crhan/frenchfinity-openscad/src/screw_driver.scad

module screw_driver_positive () {
    module stick () {
        cylinder(
            d=screwdriver_stick_width, 
            h=screwdriver_bottom_height, 
            center=false, 
            $fn=100
        );
    }
    
    module handle () {
         cylinder(
            d=screwdriver_handle_width,
            h=screwdriver_inset_height,
            center=false,
            $fn=100
        );
        
        rotate_extrude(convexity = 10)
            translate([screwdriver_handle_width / 2, screwdriver_inset_height, 0])
                circle(r = 1.5, $fn = 100);
    }
    
    union () {
        up(screwdriver_inset_height)
            handle();
        stick();
    }
}   

module screw_driver_clearance(base_height) {
    half_handle_width = screwdriver_handle_width / 2;
    half_stick_width  = screwdriver_stick_width / 2;
    polygon_front_end = half_handle_width + screwdriver_padding_sides;

    union () {
        linear_extrude(height = base_height, center= false)
        polygon([
           [-half_stick_width,  0],
           [half_stick_width,   0],
           [half_handle_width , polygon_front_end],
           [-half_handle_width, polygon_front_end]
        ]);
        rounded_corner(
            [-half_stick_width,  0, base_height],
            [-half_handle_width, polygon_front_end, base_height], 
            1.5
        );
        rounded_corner(
            [half_stick_width,  0, base_height],
            [half_handle_width, polygon_front_end, base_height], 
            1.5
        );
    }
}

module screw_driver_base (base_height, base_width_and_depth) {
    module raw_base () {        
        up(screwdriver_bottom_height)
            cube(
                [
                    base_width_and_depth,
                    base_width_and_depth,
                    base_height
                ], 
                center=true
            ); 
    }


    difference () {
        raw_base(); 
        screw_driver_clearance(base_height);
        screw_driver_positive();
    }
}

module screw_driver_holder_without_nut (base_height, base_width_and_depth) {
    module back_plate () {
        up(base_height)
        back(-base_width_and_depth/2)
        yrot(270)
        linear_extrude(height = base_width_and_depth, center= true)
        polygon(
            [
                [0,  0],
                [0,  screwdriver_padding_sides - 2],
                [screwdriver_padding_top,  screwdriver_padding_sides / 2],
                [screwdriver_padding_top ,  0],
            ],
            [[0, 1, 2, 3]]
        );
    }
    
    union () {
        back_plate();
        screw_driver_base(base_height, base_width_and_depth);
    }
}

module screw_driver_holder_without_nut_and_text (base_height, base_width_and_depth) {
    labels = hintFileName([
        final_version_prefix_calculated,
        [
            str("bh", screwdriver_bottom_height),
            str("hw", screwdriver_handle_width)
        ],
        [
            str("ps", screwdriver_padding_sides),
            str("pt", screwdriver_padding_top)
        ],
        [
            str("sw", screwdriver_stick_width),
            str("ih", screwdriver_inset_height)
        ],
    ]);

    difference() {
        screw_driver_holder_without_nut(base_height, base_width_and_depth);
        // Front face of the back plate, between the base and the cleat, never
        // smaller than the 1.0 glyph.
        labelLines(labels,
            ["x", 0, -base_width_and_depth / 2, base_width_and_depth,
             base_height + 2, base_height + screwdriver_padding_top - 14]);
    }
}

module feature_screw_driver () {
    base_height          = screwdriver_bottom_height + screwdriver_inset_height;
    base_width_and_depth = screwdriver_handle_width + (screwdriver_padding_sides * 2);
    
    up(base_height + screwdriver_padding_top - (frenchfinity_1_0_slot_distance_top * 2))
    left(base_width_and_depth/2)
    back(-base_width_and_depth/2)
    mirror([0, 1, 0])
    nut(base_width_and_depth, false);
    
    screw_driver_holder_without_nut_and_text(base_height, base_width_and_depth);
}
