crhan/frenchfinity-openscad/src/can_holder.scad

//
// Can holder  (a.k.a. can / drill / spray-can holder)
//
// Reverse engineered from the Frenchfinity 1.0 "Can-Holder" by measuring the
// reference STLs (NOT by fitting the bounding box). Fusion user parameters and
// what they ACTUALLY drive:
//
//   can_diameter (cd)  -> the can/tube the bore must fit; bore = cd + clearance
//   padding      (p)   -> SIDE/front wall around the bore; sets width dx = cd+2*p
//   can_inset    (ci)  -> bore DEPTH measured along the (tilted) bore axis
//   padding_left (pl)  -> BACK / base material
//   angle        (a)   -> how far the bore (and the can) lean OUT from vertical.
//                         This is a free 1.0 user knob (NOT encoded in the file
//                         names; the reference STLs use 10/15/20/30/40 deg). The
//                         earlier port hard-coded ~9 deg, which is why most
//                         samples looked wrong.
//
// Shape (verified against the reference STLs, every angle/perpendicularity is
// exact by construction so it tracks any `angle`):
//   * a tall UPRIGHT block, width cd+2*p, sitting on a flat base;
//   * a blind bore drilled along an axis tilted `angle` from vertical, so the can
//     leans outward (top away from the wall, easy to grab);
//   * the FRONT face is PARALLEL to the bore axis (leans out `angle` from
//     vertical), the side walls stay a constant ~p;
//   * the TOP is PERPENDICULAR to the bore axis -> a flat back deck plus a sloped
//     "roof" running down to the front-top edge (this is the sloped top the 1.0
//     has and the old flat-top port was missing);
//   * the bore mouth has a 45 deg lead-in chamfer (countersink) so the can drops
//     in easily;
//   * the vertical edges carry a small fillet (the 1.0 rounds them ~1 mm).
//   * the back wall is vertical and carries the french cleat at the top; the
//     "-hole-bottom" 1.0 variant adds a drain/push-out hole (can_holder_bottom
//     = "open").
//
// Derived size relations (consequences of the geometry; track the 1.0 STLs):
//   dx = cd + 2*p                                   (exact)
//   front face & bore lean `angle` from vertical    (exact by construction)
//   top plane is perpendicular to the bore axis      (exact by construction)
//
// Orientation: back wall (cleat) at +Y, can leans toward -Y... actually the bore
// leans toward +Y (front) going up; the cleat sits on the vertical back face.
//

can_holder_clearance = 2;     // bore = can_diameter + this (fit slack; measured cd+2)
can_holder_leadin    = 3;     // 45 deg lead-in chamfer at the bore mouth
can_holder_fillet    = 2;     // rounding radius on the FRONT + TOP edges (1.0 rounds
                              // these); the BACK / cleat edges stay sharp (joint fit)
can_holder_drain     = 6;     // drain hole diameter for bottom = "open"
can_holder_bore_bottom_extra = 4;
can_holder_text_epsilon = 0.02;
can_holder_end_roundover_excess = 0.05;

function can_holder_label_value (v) = format_fixed(v, 2);

function can_holder_outer_width () =
    can_holder_can_diameter + 2 * can_holder_padding;

function can_holder_bore_d () =
    can_holder_can_diameter + can_holder_clearance;

// --- Empirical dimension laws, fitted to ALL 50+ 1.0 Can-Holder STLs ----------
// The 1.0 part is a free-parameter family in (cd, pl, ci, p, angle); the angle is
// NOT in the file names but is one of 10/15/20/30/40 deg. Measuring every sample
// gives these laws (max residual < 0.5 mm across the whole set). They are imitation
// fits, not first-principles - the 1.0 top geometry over-constrains a clean model,
// so we reproduce the measured bounding box + deck directly.
//   dx   = cd + 2p                                   (exact)
//   deck = pl                                         (flat top depth)
//   bore = cd + 2                                     (clearance 2)
//   dy   = 10.9(cleat) + pl + C ;  dz = ci*cos(a) + K
function can_holder_C () =
    let (cd = can_holder_can_diameter, p = can_holder_padding,
         t  = tan(can_holder_angle))
    1.0122 * cd + 1.8276 * p
    - 0.1120 * cd * t - 0.2464 * cd * t * t
    - 9.0947 * t + 6.3539;

function can_holder_K () =
    let (cd = can_holder_can_diameter, p = can_holder_padding,
         r  = can_holder_bore_d() / 2, a = can_holder_angle)
    2.2371 * r * sin(a) + 18.3335 * sin(a)
    - 0.1059 * cd * tan(a) + 1.5820 * p - 5.3775;

// solid base height below the lowest bore point (measured: ~9 + 0.3*pl)
function can_holder_base () = 9 + 0.3 * can_holder_padding_left;

// total part height dz = ci*cos(a) + K(cd,p,a)  (matches the 1.0 STL height)
function can_holder_height () =
    can_holder_can_inset * cos(can_holder_angle) + can_holder_K();

// The front+top sphere-minkowski rounding pulls the rendered max-Y point IN from
// the sharp front-top corner by this much (measured: grows smoothly with the angle,
// independent of cd/p, scales with the fillet). We build the sharp corner this much
// FURTHER out so the rounded result lands exactly on the 1.0 front (pl + C).
function can_holder_front_pullin () =
    let (a = can_holder_angle)
    (can_holder_fillet / 2) * (0.04 * a - 0.00047 * a * a);

// effective sharp front extent = the 1.0 front (pl + C) plus the rounding pull-in.
function can_holder_front_eff () = can_holder_C() + can_holder_front_pullin();

// furthest-forward point of the front face, measured from the back face (Y=0):
// the rendered (rounded) value lands on pl + C (= the 1.0 front face).
function can_holder_front_max () =
    can_holder_padding_left + can_holder_front_eff();

// Z of the front-top corner: the roof (tilt a) drops front_eff*tan(a) from the deck
// (z=H, Y=pl) to the front-top corner.
function can_holder_fronttop_z () =
    can_holder_height() - can_holder_front_eff() * tan(can_holder_angle);

// front face Y at height z (the face is parallel to the bore axis, tilts `a`).
function can_holder_front_y (z) =
    can_holder_front_max()
    - (can_holder_fronttop_z() - z) * tan(can_holder_angle);

// bore floor centre Z: base solid + r*sin(a) so the lowest bore point sits at `base`.
function can_holder_floor_z () =
    can_holder_base() + can_holder_bore_d() / 2 * sin(can_holder_angle);

// bore floor centre Y: a perpendicular front-wall thickness `p` in front of the bore,
// i.e. (r + p) perpendicular behind the front plane, at the floor height. Measured
// against the 1.0 STLs the bore sits ~0.37 mm further back than (r+p) alone gives
// (consistent across samples), so nudge it back to land on the 1.0 bore axis.
function can_holder_bore_yc () =
    can_holder_front_y(can_holder_floor_z())
    - (can_holder_bore_d() / 2 + can_holder_padding) / cos(can_holder_angle)
    - 0.37;

// generous Y depth for the footprint trimming prism (front plane cuts within it).
function can_holder_depth () = can_holder_front_max() + can_holder_padding + 10;

// Z placement origin of the cleat (nut). The nut centres slot_outer_height/2
// above its origin; the 1.0 part puts the cleat CENTRE a measured ~10.19 mm below
// the part top (constant across ci / all samples), so anchor the origin there.
function can_holder_cleat_origin () =
    can_holder_height() - 10.19 - frenchfinity_1_0_slot_outer_height / 2;

// bottom Z of the label band on the back face: kept below the cleat (unchanged so
// the engraved text is unaffected by the cleat-position fix).
function can_holder_cleat_bottom () =
    can_holder_height() - 2 * frenchfinity_1_0_slot_distance_top;

function can_holder_side_profile () =
    let (H = can_holder_height(), pl = can_holder_padding_left)
    [
        [0,                        0],
        [can_holder_front_y(0),    0],
        [can_holder_front_max(),   can_holder_fronttop_z()],
        [pl,                       H],
        [0,                        H]
    ];

function can_holder_roundover_mask2d (r, steps = 16) =
    concat(
        [[0, 0]],
        [for (i = [0 : steps])
            let (a = -90 - 90 * i / steps)
            [r + r * cos(a), r + r * sin(a)]]
    );

function can_holder_profile_outward_normal (p0, p1) =
    let (dy = p1[0] - p0[0], dz = p1[1] - p0[1], l = norm([dy, dz]))
    [0, dz / l, -dy / l];

module can_holder_edge_roundover_mask (p0, p1, outward_cap, outward_side, r) {
    eps = can_holder_end_roundover_excess;
    edge = p1 - p0;
    e    = unit(edge);
    u    = -outward_cap;   // inward from the X end cap
    v    = -outward_side;  // inward from the adjacent side/top/front face
    mid  = (p0 + p1) / 2;

    multmatrix([
        [u[0], v[0], e[0], mid[0]],
        [u[1], v[1], e[1], mid[1]],
        [u[2], v[2], e[2], mid[2]],
        [0,    0,    0,    1]
    ])
        linear_extrude(height = norm(edge) + 2 * eps, center = true, convexity = 4)
            polygon(can_holder_roundover_mask2d(r));
}

module can_holder_end_roundover_masks () {
    w = can_holder_outer_width();
    r = can_holder_fillet;
    p = can_holder_side_profile();

    // End-cap perimeter is selective: the 1.0 side view rounds the front/left
    // edge and the top edges, while the back/right and bottom edges stay sharp.
    // Profile edges: 0=bottom, 1=front, 2=sloped roof, 3=back deck, 4=back.
    for (x = [0, w])
        for (i = [1, 2, 3])
            let (
                p0 = p[i],
                p1 = p[(i + 1) % len(p)],
                cap_n = x < w / 2 ? [-1, 0, 0] : [1, 0, 0],
                side_n = can_holder_profile_outward_normal(p0, p1)
            )
                can_holder_edge_roundover_mask(
                    [x, p0[0], p0[1]],
                    [x, p1[0], p1[1]],
                    cap_n,
                    side_n,
                    r
                );
}

// The outer body is a side profile extruded along X.  Use BOSL2 rounded_prism()
// so edge roundovers are native VNF geometry, not CSG patchwork.  The joint_sides
// entries correspond to the profile vertices above: back-bottom, front-bottom,
// front-top, deck/front-roof transition, back-top.  Only the front/top vertices
// are rounded; the cleat-side back edges stay sharp for wall fit.
module can_holder_outer_shell () {
    w = can_holder_outer_width();
    f = can_holder_fillet;

    translate([w / 2, 0, 0])
        multmatrix([
            [0, 0, 1, 0],   // BOSL2 extrusion Z -> model X
            [1, 0, 0, 0],   // BOSL2 profile X   -> model Y
            [0, 1, 0, 0],   // BOSL2 profile Y   -> model Z
            [0, 0, 0, 1]
        ])
            rounded_prism(
                bottom       = can_holder_side_profile(),
                height       = w,
                joint_sides  = [0, 0, f, f, 0],
                joint_bot    = 0,
                joint_top    = 0,
                k_sides      = 0.92,
                splinesteps  = 16
            );
}

module can_holder_body () {
    w     = can_holder_outer_width();
    a     = can_holder_angle;
    r     = can_holder_bore_d() / 2;
    base  = can_holder_base();
    fil   = can_holder_fillet;
    cs    = can_holder_leadin;
    yc0   = can_holder_bore_yc();
    zf    = can_holder_floor_z();
    Cf    = [w / 2, yc0, zf];                  // bore floor centre
    H     = can_holder_height();
    // axial floor -> roof opening = perpendicular distance from Cf to the roof plane
    // (roof through (pl,H), normal = bore axis), so the bore exits flush at the roof.
    L     = sin(a) * (can_holder_padding_left - yc0) + cos(a) * (H - zf);

    // One BOSL2 VNF shell with selective edge roundovers: rounded front/top
    // edges, sharp back/cleat edges, and no union seam between those treatments.
    difference () {
        can_holder_outer_shell();
        can_holder_end_roundover_masks();

        // bore drilled along the tilted axis (leans +Y going up), 45 deg lead-in.
        translate(Cf)
            rotate([-a, 0, 0]) {
                translate([0, 0, -can_holder_bore_bottom_extra])
                    cylinder(h = L + 2 + can_holder_bore_bottom_extra, r = r, $fn = 96);
                translate([0, 0, L - cs])
                    cylinder(h = cs + 2, r1 = r, r2 = r + cs, $fn = 96);
            }

        // drain / push-out hole through the base up into the bore floor
        // (1.0 "-hole-bottom" variant)
        if (can_holder_bottom == "open")
            translate([w / 2, yc0, -1])
                cylinder(d = can_holder_drain, h = zf + 4, $fn = 64);
    }
}

module can_holder_with_nut () {
    w = can_holder_outer_width();

    union () {
        can_holder_body();
        // cleat on the vertical back face (Y = 0), tongue out -Y, near the top.
        up(can_holder_cleat_origin())
            mirror([0, 1, 0])
                nut(w, false);
    }
}

module can_holder_labels_only () {
    w    = can_holder_outer_width();
    base = can_holder_base();
    z0   = base + 2;
    z1   = can_holder_cleat_bottom() - 2;
    d    = text_depth;

    lines = [
        final_version_prefix_calculated,
        str("cd", can_holder_label_value(can_holder_can_diameter)),
        str("pl", can_holder_label_value(can_holder_padding_left)),
        str("ci", can_holder_label_value(can_holder_can_inset)),
        str("p",  can_holder_label_value(can_holder_padding))
    ];

    // The 1.0 part engraves the parameter labels on the VERTICAL BACK face (the
    // cleat / wall side), below the cleat block -- NOT on the slanted front. Match
    // that: one X-reading face at Y = 0, in the z gap between the base and the
    // cleat. 1.0 uses a fixed ~3.5mm glyph, so do not scale up to text_size here.
    // Build the cutter from just outside the back face into the solid; a centred
    // text3d() cutter leaves coplanar fragments on this large triangulated face.
    if (render_text) {
        size  = text_size_min;
        pitch = size * TEXT_LINE_K;
        zt    = labelZTop(len(lines), size, z1 - z0, z0);

        for (i = [0 : len(lines) - 1])
            translate([w / 2, d, zt - i * pitch])
                xrot(90)
                    linear_extrude(height = d + can_holder_text_epsilon, center = false)
                        text(lines[i], size = size, halign = "center", valign = "center");
    }
}

module can_holder_with_nut_and_text () {
    labels = hintFileName([
        final_version_prefix_calculated,
        [str("cd", can_holder_label_value(can_holder_can_diameter)),
         str("pl", can_holder_label_value(can_holder_padding_left))],
        [str("ci", can_holder_label_value(can_holder_can_inset)),
         str("p", can_holder_label_value(can_holder_padding))],
        str("hole", can_holder_bottom)
    ]);

    difference () {
        can_holder_with_nut();
        can_holder_labels_only();
    }
}

module feature_can_holder () {
    assert(can_holder_can_diameter > 0, "can_diameter must be > 0");
    assert(can_holder_padding > 0, "padding must be > 0");
    assert(can_holder_can_inset > 0, "can_inset must be > 0");
    assert(can_holder_padding_left >= 0, "padding_left must be >= 0");
    assert(can_holder_angle >= 0 && can_holder_angle < 60, "angle must be in [0, 60)");
    assert(
        can_holder_bottom == "closed" || can_holder_bottom == "open",
        "bottom must be one of: closed, open"
    );

    can_holder_with_nut_and_text();
}
