crhan/frenchfinity-openscad/(list of files, cad)

Other CAD files:
test/labels_only_einhell.scad
test/labels_only_gridfinity.scad
test/labels_only_hammer.scad
test/labels_only_pliers.scad
test/labels_only_round.scad
test/labels_only_smallhole.scad
test/labels_only_tape.scad
test/labels_only_triangle.scad
test/labels_only_wrench.scad
