crhan/frenchfinity-openscad/(commit log)

2026-06-28 Add rectangular tool holder feature (reverse engineered from 1.0 f3d)
    Port the Frenchfinity 1.0 "Rectangular-Tool-Holder v24.f3d" Fusion 360
    model into the OpenSCAD system as a new `rectangular_tool_holder` feature.
    The 1.0 user parameters were recovered from the ParametricText template
    embedded in the .f3d (a ZIP), and the geometry was reverse engineered from
    the exported STLs:
    dx = tool_width + 10, dy = tool_length + 20.88, dz = tool_slot_height + 15
    (R^2 = 1.0); channel width = tool_width, base/front slot width = hole_width.
    Public params: tool_width, tool_length, tool_slot_height, hole_width and a
    hole_position enum (left/center/right) that folds 1.0's three separate STL
    exports in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
    [frenchfinity.scad, rectangular_tool_holder.scad]
2026-06-28 Align rectangular tool holder text + cleat fit tolerance with 1.0
    Two fixes driven by checking our output against the Frenchfinity 1.0 parts.
    Text (rectangular_tool_holder.scad):
    - Move the engraved labels off the back face (where they collided with the
    cleat tongue and got squashed on short parts) onto the two long side walls,
    matching the 1.0 layout: version + tool_width on the right wall, the slot
    dimensions on the left. Engraved 1.5 mm, vertically centred, honours
    render_text. Orientation verified via OpenSCAD renders so the text reads
    correctly (not mirrored) from each side.
    Fit tolerance (nuts.scad + frenchfinity.scad):
    - The male tongue and female groove both used the same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
    [frenchfinity.scad, nuts.scad, rectangular_tool_holder.scad]
2026-06-28 Auto-fit holder labels to the part + add regression test
    The engraved dimension labels could exceed the part on short holders: a fixed
    text size pushed the lower lines off the bottom/top edge, and because engraving
    is subtractive the overflowing lines were silently dropped (the headline
    hole-position/label was the first to go).
    - rectangular_tool_holder.scad: size the label glyphs to fit the wall in both
    height and length (capped at text_size), and place them accounting for
    text3d's baseline (not centre) vertical anchor. Calibrated glyph height
    ~1.02*size and advance ~0.66*size/char from measured renders. Extract
    rectangular_tool_holder_labels_only() as the single source of label co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
    [labels_only.scad, rectangular_tool_holder.scad]
2026-06-28 Consolidate porting workflow; stop committing STL/PNG artifacts
    Distil the rectangular-tool-holder work into reusable assets so the remaining
    1.0 models can be ported the same way:
    - tools/f3d_inspect.py: pull user-parameter names + preview out of a .f3d
    (ZIP -> Design*/BulkStream.dat -> ParametricText templates).
    - tools/stl_analyze.py: binary-STL helpers - bbox, parameter->dimension
    regression from file names, ASCII cross-section slices, feature planes.
    - docs/porting-playbook.md: model-agnostic recipe (extract params -> reverse
    geometry -> implement to 2.0 conventions -> verify -> commit) + the
    remaining-models checklist.
    - AGENTS.md: point at the playbook/tools; add the "never c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
2026-06-28 Port the Frenchfinity 1.0 pliers holder to OpenSCAD
    Reverse engineered from Pilers-Holder v16.f3d. New src/pliers_holder.scad
    exposes the two 1.0 user parameters (height, hole_diameter) and reproduces
    the verified geometry: a boot body (back plate + stepped foot), a see-through
    capsule hole (width hd) cut through the depth, a rounded saddle notch that
    splits the top into two prongs, and the standard cleat tongue on the back
    plate just below the prongs.
    Dimensions match 1.0 (R^2=1.0 regression): dx=hd+15, dz=h+6; dy=89.85 vs
    90.88 (the standard nut() is ~1mm shallower than the 1.0 tongue, same known
    gap as the rectangular holder). The cleat reuses the shared nut(), so the
    0.25mm male-tongue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
    [frenchfinity.scad, labels_only_pliers.scad, pliers_holder.scad]
2026-06-28 Port the Frenchfinity 1.0 round hanging holder to OpenSCAD
    Reverse engineered from Round-Hanging-Holder v8.f3d. New
    src/round_hanging_holder.scad exposes the four 1.0 user parameters
    (tool_diameter, holder_depth, bottom_hole_width, inset_depth) and reproduces
    the verified geometry: a box with a semicircular trough (radius td/2) running
    front-to-back between a solid front wall (labels) and a solid back wall
    (cleat), trough side rails at td/2+5, a bottom slot of width bhw under the
    trough, and an inset_depth-deep tool seat in the back wall.
    Dimensions match 1.0: dz=td+10 and dy=holder_depth+20.88 exactly (dy is ~1mm
    short from the standard nut(), the known gap); dx=td+10 holds for every bhw=2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
    [frenchfinity.scad, labels_only_round.scad, round_hanging_holder.scad]
2026-06-28 Port the Frenchfinity 1.0 hook to OpenSCAD
    Reverse engineered from Hook v11.f3d. New src/hook.scad exposes the five 1.0
    user parameters (width, height, hook_diameter, thickness, hook_end_height) and
    reproduces the verified geometry: a flat J profile in the Y-Z plane extruded by
    width in X - a vertical shank (cleat) of height h, a 180-degree bend of outer
    diameter hook_diameter, and an upturned tip of height hook_end_height.
    Dimensions match 1.0 (R^2=1.0): dx=w, dz=h exact; dy=hook_diameter+10.88, ~1mm
    short from the standard nut() (known gap). The cleat reuses the shared nut() so
    the 0.25mm fit tolerance applies automatically. Labels (v/w/h/hd/t/heh) are
    engraved on the shank front face, on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
    [frenchfinity.scad, hook.scad, labels_only_hook.scad]
2026-06-28 Audit fix: make the author's component labels overflow-proof
    The author's components (box, french_plate, screw_plate, wall_anchor,
    screw_driver) engraved labels with a fixed text_size and a fixed 7 mm line
    pitch via labelVertical(), so on a short part the lower lines ran off the
    bottom and were silently clipped (a 30 mm box showed only 1 of its 3 lines).
    This is the same overflow class the holders were fixed for.
    Add a shared adaptive labelBlockVertical() in labels.scad (same calibrated font
    maths as the holder label blocks: shrink the glyph size so the whole block fits
    the Z region AND the face width, centred). Refactor all five components to use
    it, each passing a region that clears the c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
    [box.scad, french_plate.scad, labels.scad, labels_only_block.scad, screw_driver.scad, screw_plate.scad, wall_anchor.scad]
2026-06-28 Harden labelBlockVertical against degenerate regions
    If a caller passes a Z region too small to hold any text (z1 <= z0, e.g. a
    screwdriver with a tiny padding_top) the adaptive size went negative and
    text3d failed. Compute the size unconditionally and only engrave when it is
    positive (> 0.3 mm); also guard maxchars against an empty line list. Degenerate
    screwdriver and empty-label cases now render without error.
    Claude-Session: https://claude.ai/code/session_01W3ixxEbeK4KeSbKBHGcHMV
    [labels.scad]
2026-06-28 Floor engraved labels at the 1.0 glyph size; spill to the opposite face
    Measured the Frenchfinity 1.0 font from the STLs: every part - small or large -
    engraves a FIXED ~3.5 mm glyph (~2 mm deep), it never scales down. Our adaptive
    shrink could go far below that, producing labels too small to read or print.
    New shared label system in labels.scad:
    - labelSize() clamps the glyph to [text_size_min, text_size]; text_size_min=3.5
    is the measured 1.0 floor (new global), so we never engrave smaller than 1.0.
    - labelFace() engraves one face; labelLines() spills the overflow half onto an
    OPPOSITE face when the lines do not fit one face at the floor (instead of
    shrinking further) - per the "put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
    [box.scad, french_plate.scad, frenchfinity.scad, hook.scad, labels.scad, labels_only.scad, labels_only_block.scad, labels_only_hook.scad]
2026-06-28 Audit fix (vs 1.0): wall_anchor screw head + wire bottom_angle
    Two bugs found comparing wall_anchor to its 1.0 source:
    - the screw() call passed wall_anchor_screw_thread_diameter as the head-diameter
    argument, so the screw-head countersink was sized off the thread (r1=2) and the
    declared wall_anchor_screw_head_diameter (4.3) did nothing - despite the recent
    "screw head hole" commit. Pass head_diameter now (consistent with screw_plate).
    - wall_anchor_bottom_angle was declared but never used (the 45-deg wedge was
    hardcoded). Drive the wedge's run from it (vertical leg fixed at the depth so
    the wedge still meets the body; 45 deg reproduces the original square wedge).
    Verified: bbox a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
    [wall_anchor.scad]
2026-06-28 Restore the missing src/grid.scad (feature was wired but unbuildable)
    frenchfinity.scad has included grid.scad, dispatched feature_grid(), and
    declared [Grid] params for a long time, but src/grid.scad was absent from the
    repo and from all git history, so feature="grid" only emitted a "can't find
    include" warning and rendered nothing.
    Rebuild it from the 1.0 "Grid-Holder v5" surface and the box.scad/cleat
    conventions: an open-top box split into rows x columns compartments by inner
    dividers, with the standard nut() cleat tongue on the back and adaptive labels.
    Restore 1.0's separate inner/outer wall thickness (grid_inner_wall_thickness +
    grid_outer_wall_thickness) instead of the single grid_w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
    [frenchfinity.scad, grid.scad]
2026-06-28 Document the existing-component audit (tolerance / standard / text / vs 1.0)
    Consolidates the findings: tolerance correct across all components (shared nut(),
    0.25mm male shrink); cleat positions verified within ~0.5-1.3mm of 1.0; text
    overflow fixed with the floor+spill system; and the per-component 1.0 comparison
    with what was fixed (wall_anchor screw head + bottom_angle, grid restored) vs what
    is an intentional 2.0 enhancement (screw_driver params, plate height/depth
    semantics).
    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
2026-06-28 Port the Frenchfinity 1.0 can holder to OpenSCAD (functional fidelity)
    Reverse engineered from Can-Holder v42.f3d (53 reference STLs). New
    src/can_holder.scad exposes the four 1.0 user parameters (can_diameter, padding,
    can_inset, padding_left) plus a bottom enum folding the 1.0 "-hole-bottom"
    export variant. A vertical back plate carries the cleat; an open-top cylindrical
    cup (bore = can_diameter, wall = padding) is fused in front, tilted ~30 deg so
    the can leans up and out.
    Key dimensions track 1.0: dx = cd + 2*padding (exact, R^2=1.0); dz follows the
    0.867*ci (=cos30*ci) envelope; dy within ~1.6mm. Default render 30 x 56.1 x 72.4
    vs 1.0 ~30 x 57.7 x 72.7. Cleat reuses nut() (0.25mm fit a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
    [can_holder.scad, frenchfinity.scad, labels_only_can.scad]
2026-06-28 Port the Frenchfinity 1.0 hammer holder to OpenSCAD (functional fidelity)
    Reverse engineered from Hammer-Holder v32.f3d (9 reference STLs). New
    src/hammer_holder.scad exposes the five 1.0 user parameters (width, hammer_width,
    handle_hole_width, drop_protection_height, drop_protection_width).
    A full-height (50mm) back plate carries the cleat; two side rails project forward
    from its lower half (the hammer head rests across them), the handle hangs through
    the central channel (handle_hole_width) between them, and a raised lip at the
    front of each rail (drop_protection) stops the head sliding off.
    Dimensions match 1.0 exactly except the known ~1mm nut shortfall:
    dx=width, dz=50 (constant), dy=h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
    [frenchfinity.scad, hammer_holder.scad, labels_only_hammer.scad]
2026-06-28 Port the Frenchfinity 1.0 wrench holder to OpenSCAD (functional fidelity)
    Reverse engineered from Wrench-Holder v26.f3d (35 reference STLs). New
    src/wrench_holder.scad exposes width, wrench_width, scale. A cleat base with two
    side combs whose inward teeth form a row of open-top slots; a wrench drops into a
    slot. scale scales the cross-section (X width, Z height); width sets the length
    and slot count; wrench_width is the slot gap (internal, no bbox effect).
    Key dims track 1.0: dy = width + 25.88 (exact); dx = 44.77*scale + 4.49; dz =
    max(14.2, 11.2*scale + 7.4). ww8/w56/s1 sample = 49.26 x 80.85 x 18.60 vs 1.0
    48.49 x 81.88 x 18.64 (within ~1mm). Labels on the long rail side faces (the
    short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
    [frenchfinity.scad, labels_only_wrench.scad, wrench_holder.scad]
2026-06-28 Port the Frenchfinity 1.0 small hole holder (functional, no-STL source)
    From "Small hole holder v6" .f3d, which ships NO STLs, so this is a functional
    port from the recovered Fusion parameter expressions (not bbox-verified).
    Parameters hole_width, hole_length, tool_width; recovered constants tolerance
    0.5, padding 5, wall 5, 21mm min width. A small French-cleat plate with one
    rectangular through-hole (hole_width - 0.5) x hole_length; plate = max(21,
    hw+4.5) wide x (tool_width+5) tall. Labels v/hw/tw/hl on the back face with
    floor+spill. Default bbox 21 x 14.85 x 25.
    - wire into frenchfinity.scad; add small_hole suite to test_labels_fit.py; passes
    Claude-Session: https://claude.ai/code/sess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
    [frenchfinity.scad, labels_only_smallhole.scad, small_hole_holder.scad]
2026-06-28 Port the Frenchfinity 1.0 einhell battery holder (functional, 1-STL source)
    From the Einhell battery holder .f3d / its single STL (a20). Only `angle` is a
    parameter; everything else is fixed to the Einhell PXC battery. With one sample
    the angle->geometry mapping can't be regressed, so this is a functional port: a
    back body with the cleat plus a reclined U-channel cradle (floor + two side
    walls, open top) that the battery drops into. `angle` reclines the cradle.
    dx=55 matches; default bbox 55 x 120 x 95 vs the 1.0 a20 sample 55 x 111 x 89
    (within ~10mm, same long-reclined proportions). Labels (v / a) on the back body
    face. Heavily caveated in the file: single sample, dims/angle-mapping infer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
    [einhell_battery_holder.scad, frenchfinity.scad, labels_only_einhell.scad]
2026-06-28 Port the Frenchfinity 1.0 gridfinity adapter to OpenSCAD (functional fidelity)
    Reverse engineered from the Gridfinity-Frenchfinity Adapter (4 reference STLs).
    New src/gridfinity_adapter.scad exposes grid_columns, grid_rows, angle. A wedge
    hangs on the cleat; a standard gridfinity 42mm baseplate (cols x rows cells with
    the chamfered clip socket) sits on the wedge's slanted top, tilted ~2*angle from
    horizontal (all four 1.0 samples are angle=10 and measure a 20deg bed).
    Key dims track 1.0: dx = 42*columns (exact); dy = 42*cos20*rows + 14.1;
    dz = 42*sin20*rows + 8.83. gr3/gc3/a10 = 126 x 133.96 x 48.10 vs 1.0
    126 x 132.5 x 51.93 (dx exact, dy/dz within ~4mm). Labels v/gr/gc/a on the back
    wall.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
    [frenchfinity.scad, gridfinity_adapter.scad, labels_only_gridfinity.scad]
2026-06-28 Evaluate extra source-dir models (task 15)
    Beyond the original 9-model checklist (all now ported), the 1.0 source dir has
    three more models not previously scanned: Bit/Drill Holder (r,c,hd,hp,a,h - a
    grid of angled bit holes), Tape Holder (tw,matd,mitd,rd - a spool holder), and
    Triangle Top Holder (a loose f3z with no STLs/templates, params unknown).
    1740069021_Rectangular and Frenchfinity-Bit-Holder are duplicates of already
    -ported parts; Screwdriver-Holder is the existing screw_driver. Recorded in the
    playbook as the candidate follow-up set.
    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
2026-06-28 Port the Frenchfinity 1.0 bit/drill holder (functional fidelity)
    From "Bit-Holder v68.f3d" (85 STLs). New src/bit_holder.scad exposes rows,
    columns, hole_diameter, hole_padding, angle, height. An r x c grid of bit holes
    drilled at `angle` (1.0 uses 30deg) into a block, cleat on the back.
    dx = columns*(hd + 2*hp) (exact); dz = 1.5*height + 10. NOTE: 1.0 packs the rows
    into a leaning parallelogram (compact); the scattered samples don't share params
    across row counts, so the exact per-row slant pitch isn't regressable. We use an
    upright block with angled holes instead - functionally identical (bits tilt at
    `angle`), dx/dz on target, but dy runs larger than 1.0's parallelogram for
    multi-row. Do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
    [bit_holder.scad, frenchfinity.scad, labels_only_bit.scad]
2026-06-28 Port the Frenchfinity 1.0 tape holder (functional fidelity)
    From "Tape Holder" (13 STLs). New src/tape_holder.scad exposes tape_width,
    max_tape_diameter, min_tape_diameter, rod_diameter. A block with a concave
    cylindrical scoop (radius ~matd/2) the tape roll rests in, open toward the
    front; a back wall carries the cleat.
    Dims track 1.0: dx = tape_width + 20 (exact); dy = max_tape_diameter + 20.88;
    dz ~= 0.69*min_tape_diameter + 16.4. tw20/matd65/mitd45 = 40 x 84.85 x 47.63 vs
    1.0 40 x 85.88 x 43.75. Labels v/tw/matd/mitd/rd on the front.
    - wire into frenchfinity.scad; add tape suite to test_labels_fit.py
    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
    [frenchfinity.scad, labels_only_tape.scad, tape_holder.scad]
2026-06-28 Triangle Top Holder: recovered params, skip impl (no geometry to verify)
    The f3z is an XRef container; recovered the params from the nested f3d
    (tool_width~18, holder_height, triangle_height, tool_depth). But there is no
    STL, the preview only shows the XRef'd wall plate, and there are no structural
    dimension expressions, so the actual "triangle top" shape and the param->geometry
    mapping can't be determined. Building from param names alone would be inventing,
    not porting, so it is documented and skipped with a recommendation to export an
    STL from Fusion. Bit and Tape holders are now ported.
    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
2026-06-28 Fix bit_holder column width + rename tape rod->rest_diameter (1.0 fidelity)
    Two fidelity fixes surfaced while writing the reverse-engineering reports and
    re-measuring the 1.0 STLs:
    - bit_holder: 1.0 SHARES the inner wall between columns, so dx = c*hd + (c+1)*hp,
    not c*(hd+2hp). The old formula made multi-column parts (c-1)*hp too wide
    (e.g. c2 hd9.6 hp10: mine 59.2 vs 1.0 49.8). Columns now pitch by hd+hp with hp
    on each edge; dx matches 1.0 for all column counts (c1 unchanged). Rows keep the
    wider cell pitch (the tilted holes need the Y margin) - multi-row dy still runs
    larger than 1.0's parallelogram, as documented. test bh_bounds updated to the
    real width.
    - tape_holder: 1.0'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
    [bit_holder.scad, frenchfinity.scad, labels_only_tape.scad, tape_holder.scad]
2026-06-28 Add reverse-engineering reports for the 8 newer ports
    docs/reverse-engineering-{can,hammer,wrench,small-hole,einhell,gridfinity,bit,
    tape}-holder.md, matching the existing hook/pliers/round report format. Each
    documents the f3d parameter template, the stl_analyze regression (or notes when
    there's no/one STL to regress), the geometry, implementation notes, and a
    mine-vs-1.0 bbox check. Numbers are tool-measured or from the verified .scad
    headers; functional-fidelity deviations are stated honestly.
    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
2026-06-28 Port the Frenchfinity 1.0 Triangle Top Holder (functional fidelity)
    Previously skipped (loose f3z, no STL); the user exported 2 STLs from Fusion, so
    it's now ported. New src/triangle_top_holder.scad exposes tool_width, tool_depth,
    holder_height, triangle_height.
    Shape: a flat front plate (text), a top tool cradle (pocket tw x td, open top)
    with the french cleat behind it, and a bottom-back triangular foot of height
    triangle_height (the "triangle") that braces the plate against the wall.
    Dims verified exact against both STLs: dx = tool_width + 12, dy = tool_depth +
    20.88, dz = holder_height + 5. A(tw35 hh100 th25 td17.5) = 47/37.35/105 vs 1.0
    47/38.38/105; B(tw96 hh155 th47 td11) = 108/30.8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
    [frenchfinity.scad, labels_only_triangle.scad, triangle_top_holder.scad]
2026-06-28 Rewrite can_holder with correct geometry (was bbox-overfit, shape was wrong)
    The previous can_holder matched the 1.0 bounding box via a multivariate
    regression but had completely wrong geometry: it exposed a near-horizontal
    tilted cylinder on a thin plate (a can would point sideways and fall out),
    instead of the 1.0 shape.
    Re-derived the real shape by measuring the reference STLs cross-section by
    cross-section (isolating each parameter), NOT by fitting the bbox:
    - tall UPRIGHT block, deep blind bore drilled from the TOP, tilted ~9deg
    so the can leans outward (top away from the wall)
    - vertical back wall carries the cleat; front face slanted parallel to the
    bore (top-heavy), con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
    [can_holder.scad]
2026-06-28 Rebuild wrench_holder with correct comb-rack geometry (was bbox-overfit)
    The old wrench_holder matched the 1.0 bbox via regression but its shape was
    wrong: a deep walled trough with full-height inward teeth read as a block of
    square pockets, not the 1.0 comb rack. Verified against the 1.0 STL cross
    sections + top-down render:
    - full-width cleat block at the back (tall),
    - TWO continuous side rails cantilevering forward, OPEN channel between them
    (no floor) -- the old channel floor was invented,
    - notches (slot width = wrench_width) cut from the top into the INNER edge of
    each rail; the outer edge stays continuous. A wrench drops into an aligned
    inner-notch pair, head on th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
    [labels.scad, wrench_holder.scad]
2026-06-28 Rebuild tape_holder with the spindle rod it was missing (was non-functional)
    The earlier tape_holder was a scooped box with NO central rod: rest_diameter
    was only used in the label text, never in geometry, so the roll had nothing to
    spin on -- the part could not do its job. Verified against the 1.0 iso/side
    renders + cross sections, the 1.0 tape holder is:
    - a wedge body (tall at the back where the cleat is, sloping down to a low
    front), extruded across the full width,
    - two tall end walls (horns) flanking a tw-wide slot,
    - a concave cradle (radius matd/2) scooped into the slot so the roll nests,
    - a thin SPINDLE ROD of diameter rest_diameter bridging the slot through the
    ro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
    [tape_holder.scad]
2026-06-28 Rebuild round_hanging_holder: open front + tall back neck (was a closed box)
    The earlier port added a tall FRONT wall the 1.0 has no, and only scooped the
    trough in the centre, leaving full-height side walls -- so the side profile was
    a closed rectangle instead of the 1.0 "solid base + tall back neck" L. Verified
    against the 1.0 STL cross sections (mid-X is empty front-to-bottom; z=45 shows
    only the back wall) and the iso/side renders:
    - a semicircular trough (radius td/2, axis front-to-back) scooped into the top,
    centre near the block top so the tool top ~= block top,
    - the whole top in front of the back wall is opened (side walls cut down to the
    trough centre) -> the 1.0 seaho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
    [round_hanging_holder.scad]
2026-06-28 Rebuild einhell_battery_holder as a flat seat slab (was a deep U cradle)
    The earlier port was a deep U-channel cradle; the 1.0 (single STL, a20) is a
    long THIN flat seat slab leaning up/back from a small base, with two shallow
    guide rails along its edges and a ~38 mm channel between them that the Einhell
    PXC battery slides into. Verified against the STL cross sections (the slanted
    slab is a thin parallelogram; z-slices show two edge rails + a wide channel)
    and the iso/side renders.
    - small base block at the bottom carries the cleat (+Y),
    - thin seat slab (12 mm) tilts up by ~angle+11 deg (a20 -> 31 deg gives the
    55x111x89 bbox: built 55x112x91),
    - two 8 mm edge rails + 38 mm batte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
    [einhell_battery_holder.scad]
2026-06-28 Rebuild bit_holder as a leaning slab so rows stack up, not out
    The earlier port was an upright block with the holes in the top and rows pitched
    in Y -- for multi-row it grew into a long horizontal cantilever (r5: dy~166)
    instead of the 1.0's compact wall panel. Verified against the 1.0 cross sections
    (r3c1: rows step up-and-back along a slant, pitch hd+hp; dy70.6/dz55.5) and the
    mounting-orientation render:
    - a flat slab holds the r x c hole grid drilled perpendicular to its face,
    pitched hd+hp in BOTH axes (columns AND rows share inner walls),
    - the slab reclines `angle` from horizontal so the bits project out/up and the
    rows stack UP the slab -> compact panel (built r1 30x42x3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
    [bit_holder.scad]
2026-06-28 Rebuild hammer_holder cradle as a rounded U-notch (was offset split rails)
    The earlier port used two SEPARATE side rails with a flat-bottomed rectangular
    channel between them, which read as offset blocks, not the 1.0 cradle. Verified
    against the 1.0 front/iso renders + cross sections (the front face is solid; a
    rounded U-notch is cut from the top centre):
    - a tall (50) back plate carries the cleat,
    - a lower SOLID cradle block sits in front with a central handle U-notch
    (width handle_hole_width, ROUNDED bottom) cut from the top,
    - a solid front wall (drop_protection_width) keeps the front face intact (the
    notch is behind it) and rises drop_protection_height above the seat,
    -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
    [hammer_holder.scad]
2026-06-28 Rebuild triangle_top_holder as a solid plate (was hollow with a deep cup + foot)
    The earlier port made a thin front plate with a full-depth top CUP and a big
    tapering foot, leaving the middle hollow -- nothing like the 1.0 solid plate.
    Verified against the 1.0 STL cross sections (a ~solid plate, tool slot at the
    top, small bottom-back gusset) and the iso/side renders:
    - a SOLID plate (depth td + 10) the full height,
    - the tool slot (tw x td) cut into the TOP,
    - the french cleat on the back near the top,
    - a small triangular gusset on the bottom-back (height th) bracing the wall
    below the cleat (stays within the cleat's Y so dy is unchanged).
    bbox 47x37.35x105 vs 1.0 47x38.38x10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
    [triangle_top_holder.scad]
2026-06-28 AGENTS.md: record the bbox != shape lesson + NAS dir-rename gotcha
    After the 2026-06-29 shape-fix campaign (8 holders rebuilt from real geometry
    because they were bbox-overfit and shape-wrong), document the rule: verify ports
    by RENDERING ours vs the 1.0 STL and looking, not by bbox regression. Also note
    the 1.0 source dirs may use clean names now and stl_analyze needs binary STL.
    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
2026-06-28 Refine pliers_holder: solid front face (was a see-through slot)
    The 1.0 pliers holder loads from the TOP and its front face is closed (the
    V-slot converges to near-solid at the front); the earlier port cut the capsule
    hole + saddle clean through the front, so it read as a see-through slot.
    Bound both cuts to the seat depth (Y in [front_wall, body_depth - plate]) so the
    front wall and the back/cleat plate stay solid -- the pliers still drop in from
    the top, but the front face is now solid like the 1.0. Labels move from the side
    walls onto that solid front face (X-read, reads correctly).
    bbox unchanged (33x89.85x86 vs 1.0 33x90.88x86). test/test_labels_fit.py: 66/66.
    Claude-Session: https:/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
    [pliers_holder.scad]
2026-06-28 Refine gridfinity_adapter cells to the standard baseplate socket profile
    The earlier port approximated each cell as a single 2.4 mm chamfer + straight
    pocket; real gridfinity bins clip into the standard 3-step baseplate socket.
    Replace gf_socket with the canonical profile (heights from the top opening down):
    2.15 mm 45deg lead-in chamfer, 1.8 mm vertical, 0.8 mm 45deg chamfer (4.75 mm
    total), corner radius 3.75 -- so a real gridfinity bin foot seats/clips.
    3x3 macro form + bbox unchanged (dx 126 exact; dy/dz match the prior wedge port).
    test/test_labels_fit.py: 66/66 pass.
    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
    [gridfinity_adapter.scad]
2026-06-28 Fix bit_holder bores never being drilled (cylinders sat above the slab)
    The leaning-slab rebuild placed each bore cylinder at z = t+1, 1 mm ABOVE the
    slab top face (z = t), so it never intersected the slab and difference() was a
    no-op -- the slab came out solid with no holes (bbox unchanged, so it slipped
    through visual checks; caught while rewriting the RE doc). Drill from the top
    face down by `height` (z in [t-height, t+1]), leaving the `floor` solid below.
    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
    [bit_holder.scad]
2026-06-28 Rewrite the 10 reverse-engineering docs off the rebuilt geometry
    The RE reports for the 8 rebuilt holders (can/wrench/tape/round_hanging/einhell/
    bit/hammer/triangle) plus the 2 refined ones (pliers/gridfinity) described the
    old bbox-overfit geometry and were stale. Rewritten to match the current src/*
    implementations, with fresh bbox-vs-1.0 verification numbers and a per-doc
    2026-06-29 rebuilt/refined note. (The bit doc's rewrite is what surfaced the
    undrilled-bore bug fixed in the previous commit.)
    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
2026-06-29 Rebuild can_holder to match 1.0 shape (sloped ⊥-bore top, lead-in, fillets)
    第二轮按图形复核发现 can 不止「少倒圆角」，而是整个顶部+倾角模型都错：
    - 倾角是 1.0 的自由用户参数（filename 不编码，样本实测 10/15/20/30/40°），
    旧版硬编码 9°。新增 can_holder_angle（默认 10）暴露它。
    - 顶面应垂直于 bore 轴（后平台 + 前斜屋脊），旧版是水平平顶。
    - bore 口缺 45° 锥形导入倒角；竖棱缺 ~1mm 圆角（用户说的「倒圆角」）。
    改用构造法（半空间求交，让 OpenSCAD 算三角函数）：圆角足迹棱柱 ∩ 前斜面(∥bore)
    ∩ ⊥bore 顶面 − bore(带导入锥)。竖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
    [can_holder.scad, frenchfinity.scad, labels_only_can.scad]
2026-06-29 gitignore local FrenchFinity/ 1.0 reference mirror
    用户把远端 NAS 挂载点整体拷到本地 FrenchFinity/，作逆向/STL 对照的参考数据，
    不进 Git。
    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
2026-06-29 can_holder: engrave labels on the vertical back face (match 1.0)
    One-by-one STL parity review, round 3. Rendered ours vs the 1.0 STL
    (cd23/pl18/ci55/p8, angle measured ~20deg) at iso/side/top/label-face
    PNGs and compared by eye. The shape (lean / perpendicular-to-bore top /
    45deg lead-in / vertical-edge fillets ~1mm / cleat position / flat base)
    already matched 1.0 after the previous rebuild. The real remaining
    defect was the LABEL FACE: 1.0 engraves v1/cd/pl/ci/p on the vertical
    BACK face (cleat / wall side) below the cleat, but the port engraved them
    on the slanted front. That is what still looked wrong.
    - move labels to the back face via the shared labelFace "x" pattern
    (same as einhel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
    [can_holder.scad, labels_only_can.scad]
2026-06-29 can_holder: selective edge rounding (front+top round, back sharp) + complete bore opening
    Round 4 of the one-by-one STL parity review. The user loaded ours vs the
    1.0 STL in a slicer and flagged three concrete defects:
    1. The front-TOP edge is rounded on 1.0 but was sharp on the port. The
    old vertical-cylinder minkowski only rounded the 4 upright edges and
    left every horizontal/top edge sharp.
    2. The BACK vertical edges (cleat / wall side) were rounded by that same
    minkowski, which the user said breaks the french-cleat joint seat -
    the joint side must stay sharp.
    3. The bore opening on the top was clipped by the flat back deck, leaving
    an incomplete rim.
    Fixes:
    - Selective r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
    [can_holder.scad]
2026-06-29 can_holder: exact dimensions from measuring 50+ 1.0 STLs (deck=pl, back_wall, bore_d, L=ci)
    Round 5 of the parity review - the user requires precise dimensions, so I
    reverse-engineered the 1.0 geometry across 50+ reference STLs. The angle is a
    free user parameter taking discrete values 10/15/20/30/40 deg (NOT encoded in
    the filenames; recovered cleanly from the front-face facet normal). Measured,
    validated relationships now hardcoded:
    dx = cd + 2*p (exact)
    bore_d = cd + 2 (measured cd+2.00; clearance=2)
    deck = pl (the flat top deck depth IS padding_left -
    measured pl18->18.3, pl12->12.4, ... one-by-one)
    ba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
    [can_holder.scad]
2026-06-29 can_holder: fit dy/dz to ALL 50+ 1.0 STLs (dz/deck/dx exact; dy off by cleat constant)
    Round 6 - the user requires every sample in FrenchFinity/Can-Holder to be
    satisfied. Measured all 50+ samples and fit empirical dimension laws (the 1.0
    top geometry over-constrains a clean first-principles model, so per "imitate
    first" I reproduce the measured bbox + deck directly):
    dx = cd + 2p (exact)
    deck = pl (exact)
    bore = cd + 2 (exact)
    dz = ci*cos(a) + K(cd,p,a) (K fit, max residual 0.25mm)
    dy = 10.9 + pl + C(cd,p,a) (C fit, max residual 0.28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
    [can_holder.scad]
2026-06-29 nut: outer_width 5.6->6.6 to match 1.0 (global cleat fix); can dy now exact
    Per the user (match 1.0 exactly), reverse-engineered the shared french-cleat:
    1.0's male tongue protrudes 10.9mm = neck 6.6 + head 4.5 - 0.25 tolerance; the
    female groove is 11.1mm. The repo's outer_width was 5.6, making EVERY part's
    cleat ~1mm too short / incompatible with 1.0 - exactly what the original author
    warned about in the frenchfinity.scad comment ("set this to 6.6 or 6.5 ...
    compatible to legacy frenchfinity parts").
    - frenchfinity.scad: frenchfinity_1_0_slot_outer_width 5.6 -> 6.6. This is the
    shared joint, so it lengthens the cleat on ALL 18 features by ~1mm (toward 1.0).
    Keeps the 0.25 FDM toleranc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
    [can_holder.scad, frenchfinity.scad]
2026-06-29 docs(can): record cleat-fit verification — tongue fits 1.0 groove at 0mm³
    Clean intersection test proves our can tongue mates with the 1.0 wall-anchor
    groove with 0.0000 mm3 interference (0.125-0.25mm clearance everywhere). The
    1.0 cleat is a rectangular T-slot, not an angled dovetail — there is no
    back-corner chamfer to reverse-engineer, so nut() needs no change. The earlier
    "~165mm3 / chamfer the nut" finding was a ~0.5mm alignment artifact (test on the
    original wall anchor in a different coord frame); documented the lesson that a
    fit intersection test is only valid in a verified-aligned pose.
    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
2026-06-29 nut: make slot_tolerance a per-side clearance (0.25/side = 0.5mm total)
    The fit clearance was applied as a total per-dimension shrink (0.25 split into
    0.125 per face on the centred Z dims, 0.25 on the one-sided tip), giving uneven
    per-side gaps. Per the user's intent, redefine frenchfinity_1_0_slot_tolerance
    as the PER-SIDE clearance: every free face of the male tongue is pulled back the
    full value, so neck/head Z heights shrink by 2*tolerance and the tip by
    tolerance. With 0.25 the result is a uniform 0.25mm per side / 0.5mm total gap.
    Verified on the can: neck Z 6.0, head Z 8.0, tip protrusion 10.85 -> 0.25/side
    everywhere; still mates the 1.0 wall-anchor groove at 0mm3 (looser than befor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
    [frenchfinity.scad, nuts.scad]
2026-06-29 tools: add stl_diff.py — quantify how close our STL is to a 1.0 STL
    A reusable shape-comparison tool that answers "how alike are these two STLs"
    and shows WHERE they differ — the project's core need (bbox parity != shape
    parity). It auto-aligns the two meshes (48 axis orientations + ICP translation,
    so 1.0 Fusion exports at arbitrary position/orientation/mirror just work, no
    hand-tuned translate()), then reports symmetric surface distance (Chamfer /
    Hausdorff) + volume ratio + bbox match, localizes the extra/missing-material
    regions, and renders red/blue difference views.
    Demonstrated on the can: bbox matches to 0.04mm yet surface deviation is
    mean ~0.6 / max ~4.3mm — bbox-right but s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
2026-06-29 can: align bore Y + cleat Z to the 1.0 STL (found via stl_diff)
    stl_diff flagged two real shape offsets the bbox hid (verified constant across
    two samples, cd23 ci55 + ci80):
    - cleat sat 1.34mm too low. The 1.0 cleat centre is a measured ~10.19mm below
    the part top (constant across ci); placed the nut origin there via the new
    can_holder_cleat_origin() instead of the ad-hoc H - 2*slot_distance_top.
    - bore axis sat ~0.37mm too far forward in Y; nudged bore_yc back to land on the
    1.0 bore axis.
    After the fix both offsets measure ~0 on both samples; the stl_diff verdict goes
    DIFFERENT -> CLOSE (p95 1.59 -> 1.0mm). Label band (cleat_bottom) left unchanged
    so the engraved text is unaffected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
    [can_holder.scad]
2026-06-30 can: selective fillet — round front+top, keep back edges sharp, no seam
    User flagged a step/notch at the back-top and back-bottom corners: the body was
    union(separately-rounded front, SHARP back slab), and the slab's Y<=kb boundary
    cut across the rounded side-top/side-bottom edges, leaving a sharp↔round step.
    Replace with a single continuously-rounded body (sphere-minkowski over the whole
    solid) and UNION back only the sharp BACK edges via thin boxes that hug just those
    edges (back-left/right vertical + back-top), so their inner clip faces sit INSIDE
    the solid and leave no surface seam. This matches 1.0 (measured: back edges sharp,
    front/top rounded) as one continuous body.
    stl_diff: 6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
    [can_holder.scad]
2026-06-30 can: round the whole body as one (no seam) — drop the sharp back special-case
    Keeping the back edges sharp meant unioning a sharp piece onto the rounded body,
    which in CSG always leaves a step where the sharp and rounded surfaces meet (the
    user circled raised strips + notches on the deck/back-top; making the piece thinner
    only thinned the step). OpenSCAD can't taper a fillet to a runout like a B-rep
    kernel, so sharp-meets-rounded is unavoidably a step.
    Round the single solid uniformly (sphere-minkowski over the whole thing) so the
    fillet is continuous everywhere — no step. The back FACE stays flat (minkowski grow
    + solid inset cancel on flats) so the french cleat still seats flat; only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
    [can_holder.scad]
2026-06-30 can holder: rebuild shell roundovers with BOSL2
    Use BOSL2 rounded_prism for the can holder outer shell so front/top roundovers and sharp cleat-side edges are generated in one VNF instead of patched together with sphere minkowski CSG. Document the validation and the local OpenSCAD x86 CLI pitfall.
    [can_holder.scad]
2026-06-30 Add CadQuery can holder generator
    Provide a uv-run CadQuery experiment that mirrors the current reverse-engineered can-holder geometry, parses 1.0 STL filenames, auto-selects the hidden angle by bbox, exports STL, and can invoke stl_diff for verification.
2026-06-30 can holder: quantify and tighten v2.1 geometry
    [can_holder.scad]
2026-06-30 Fix CadQuery can holder text and back edge
    Use an explicit back-face plane so labels read correctly from the cleat side, and stop filleting the side/end edges that make the 1.0 back face look rounded. Regenerate validation against the cd23/pl22/ci80/p8 review sample and all 53 can-holder references.
2026-06-30 can holder: keep back face sharp and clean labels
    [can_holder.scad]
2026-06-30 Add CadQuery can holder side-edge fillets
    Eases only the exposed front/side edges with a small fillet while keeping the wall-facing cleat side sharp. Validated against the cd23/pl22/ci80/p8 review sample and all 53 can-holder references, with and without text.
2026-06-30 Add STL feature profile comparison tool
    Introduce a side-front-profile check that aligns a reference STL to a candidate and measures side-edge pullback by slice offsets. This catches local fillet/chamfer mismatches that aggregate STL distance metrics can hide.
2026-06-30 can holder: round only selected end-cap edges
    [can_holder.scad]
2026-06-30 Fix build123d can-holder feature geometry
    Round side/end edges and bore mouths, add the lower-front push-out opening for hole-bottom variants, and add a can-holder audit command that checks these features against 1.0 references.
